ashraffbarakat/omni-you-autonomous-robot/Images/1 (1).jpeg

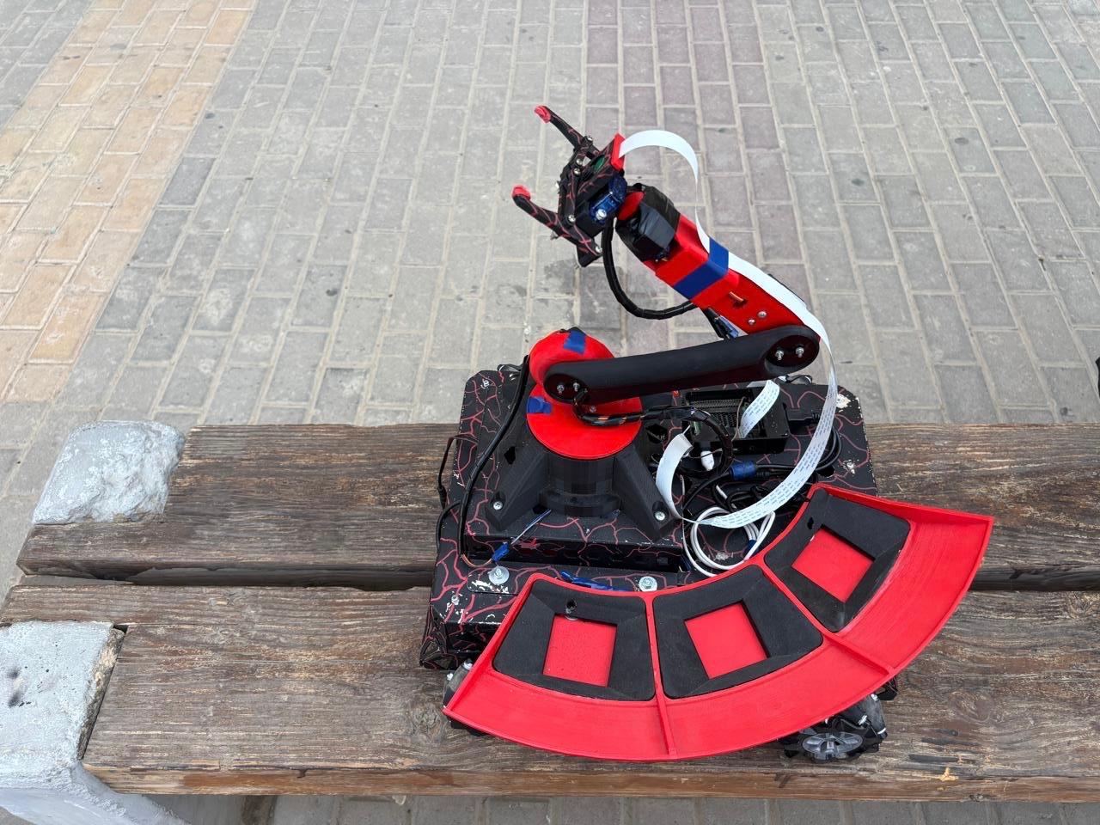
Images/1 (1).jpeg
