ashraffbarakat/omni-you-autonomous-robot/Images/1 (2).jpeg

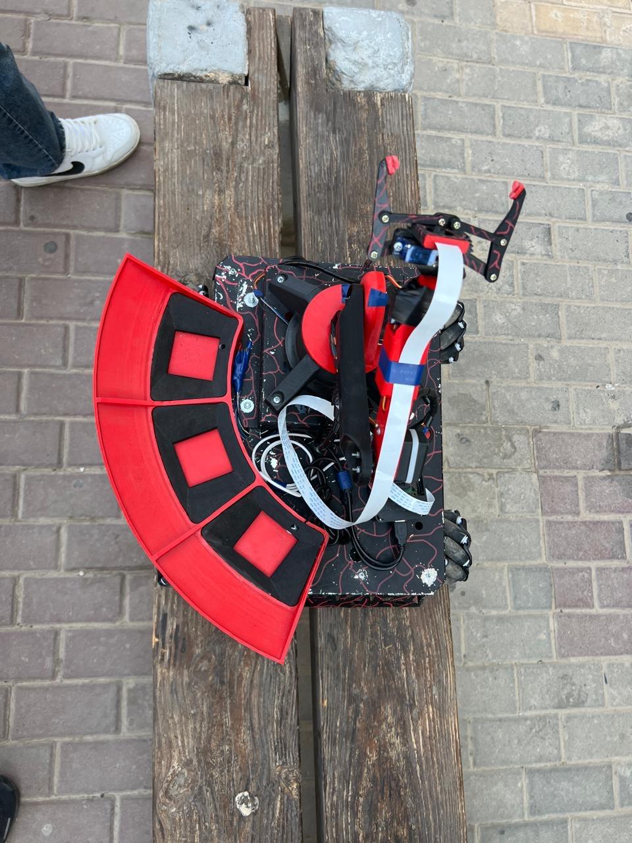
Images/1 (2).jpeg
