ashraffbarakat/omni-you-autonomous-robot/Images/1 (3).jpeg

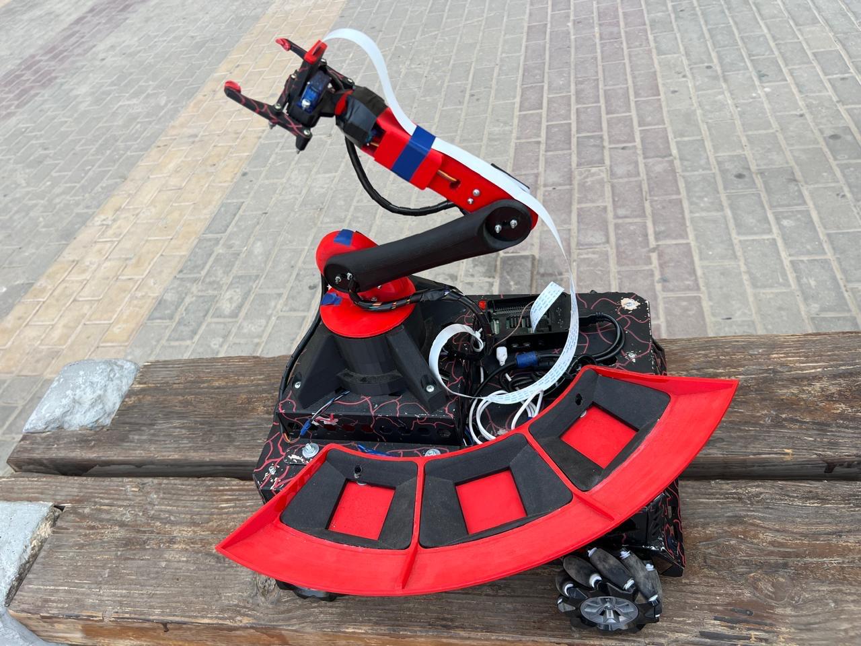
Images/1 (3).jpeg
