ashraffbarakat/omni-you-autonomous-robot/Images/1 (4).jpeg

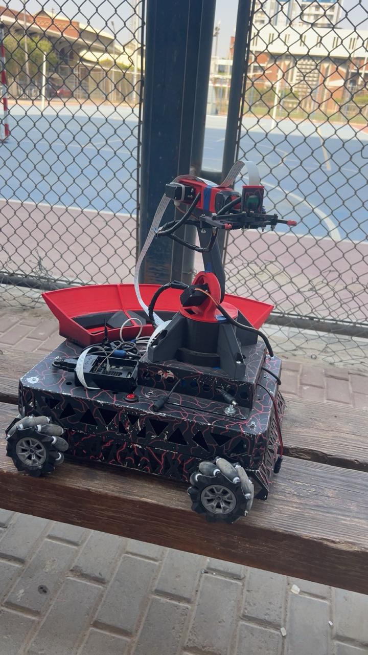
Images/1 (4).jpeg
