ashraffbarakat/omni-you-autonomous-robot/Images/1 (5).jpeg

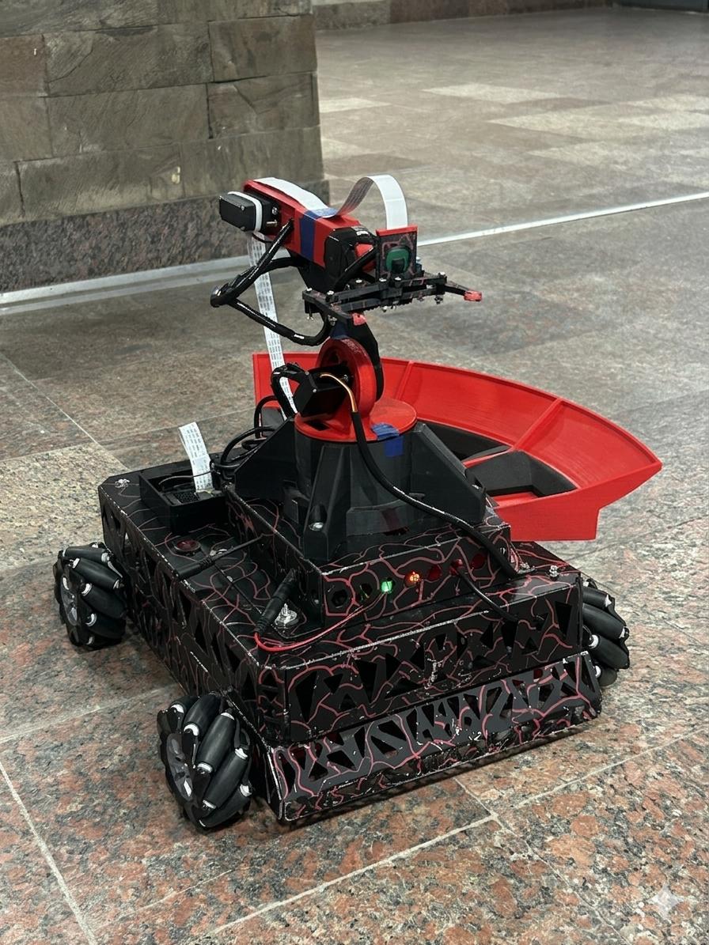
Images/1 (5).jpeg
