ashraffbarakat/omni-you-autonomous-robot/Images/2 (1).jpeg

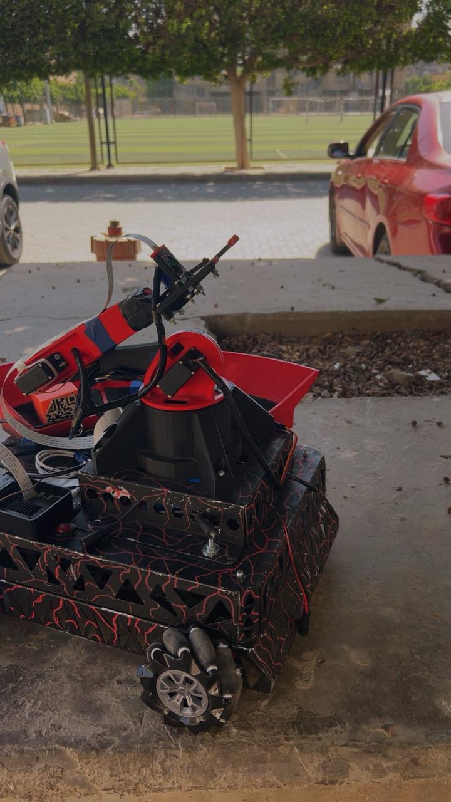
Images/2 (1).jpeg
