ashraffbarakat/omni-you-autonomous-robot/Images/2 (2).jpeg

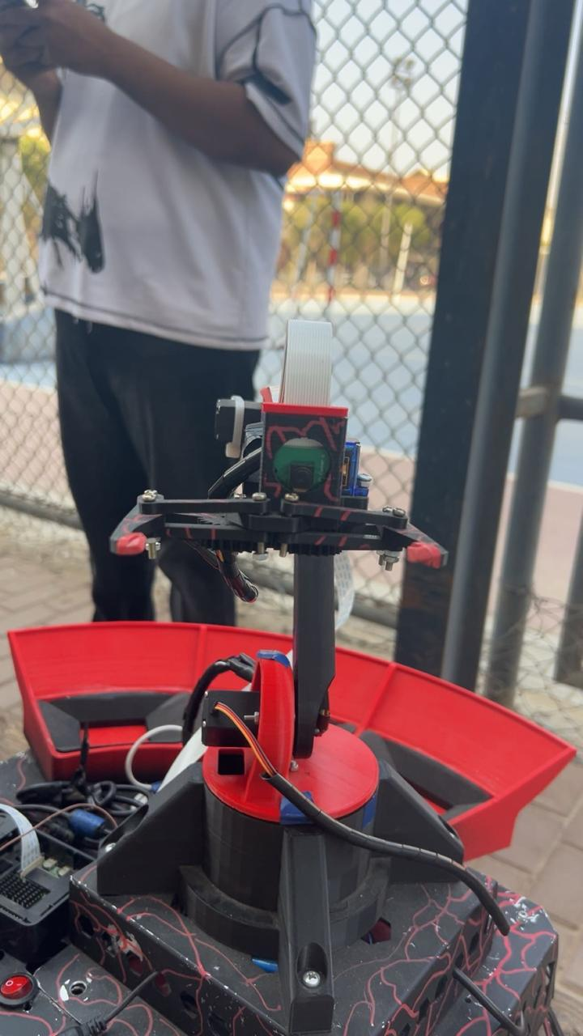
Images/2 (2).jpeg
