ashraffbarakat/omni-you-autonomous-robot/Images/2 (3).jpeg

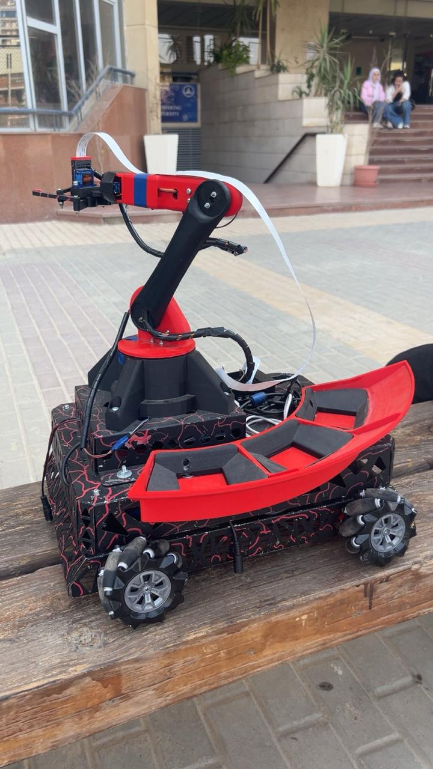
Images/2 (3).jpeg
