ashraffbarakat/omni-you-autonomous-robot/Images/Robot.jpg

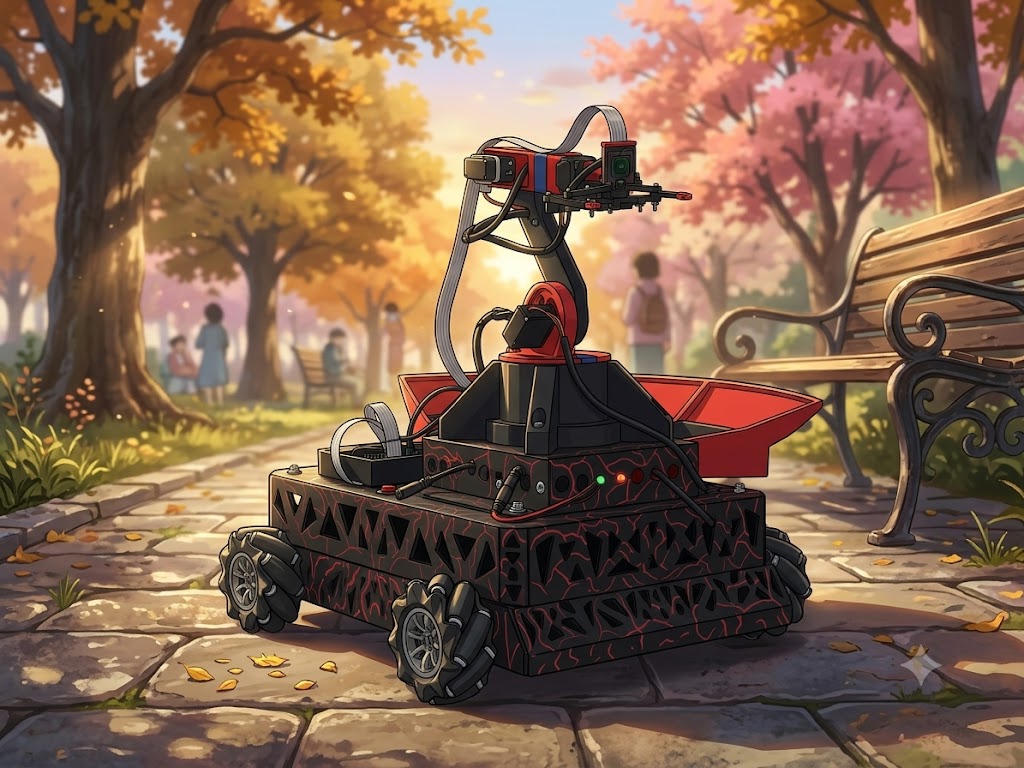
Images/Robot.jpg
