ashraffbarakat/omni-you-autonomous-robot/(commit log)

2026-07-01 Create Arduino_Mega folder
2026-07-01 Add README.md for Arduino Uno source code
2026-07-01 Add README.md for Raspberry Pi source code
