ashraffbarakat/omni-you-autonomous-robot/(notices)

Notices in the files:
README.md:
MIT License
